tylerkolden/desktop-companion-robot/docs/PLAN.md

# Development plan

## Current teaching architecture

Seven separate lesson pages and sketches replace the stacked Companion lesson flow. Test acceleration, rotation rate, die temperature, OLED and servo control independently, then integrate. Shared command handling keeps the interface consistent. The owner reports all seven current lessons completed successfully, including satisfactory larger servo movement. This is user-reported bench evidence, not a measured mechanical-range or four-leg validation. See the test log.

## Current build checkpoint

[Checkpoint 4: screw-retained servo mount](BUILD-CHECKPOINT-04.md) is current. Preserve the owner-approved 23 x 12.9mm opening. V4 replaces snap tabs with two M2 x 10mm machine screws, nuts and flat washers; cable entry moves to the long side. Print and check one before designing the chassis. M2 passage through the actual ear holes, cable insertion, washer seating and retention remain unverified. The sensor/personality app is paused at the owner's request. No assembled leg should use the bare-servo sweep without checking its mechanical limits.

## Milestone 0: documented starting point

- [x] Add repository-local pinned tool bootstrap and a documented Windows terminal workflow.
- [x] Add standalone Hello, Scanner, Face, and Motion teaching sketches with staged lessons.
- [x] Document beginner setup, command meanings, troubleshooting, experiment records, and contribution workflow.
- [ ] Have a new learner follow the guide and record confusing steps.

- [x] Study upstream code and missing model situation.
- [x] Record owned hardware and Amazon-only selections.
- [x] Choose solder-free assembly, corded V1 and cordless V2.
- [x] Draft wiring, measurement, build and validation instructions.
- [x] Owner confirmed all additional V1 parts are in hand.
- [ ] Complete receipt checks and physical validation.

## Milestone 1: bench diagnostics

- [x] Implement serial commands, scanning, display, IMU polling and one-channel calibration in `firmware/Companion/` (physical validation pending).
- [x] Add I2C scanner and serial diagnostics; compile for XIAO ESP32C3.
- [x] Pin exact board/library versions and document a repeatable build.
- [ ] Validate OLED and IMU separately.
- [x] Implement PCA9685 one-servo calibration with outputs disabled at initialization; hardware behavior still requires validation.
- [ ] Measure supply behavior and calibrate four unloaded servos.

Exit: repeatable upload, detected modules, stable power, recorded calibration.

## Milestone 2: editable mechanical design

- [x] Create and mesh-check original servo/OLED outline fit gauges with editable OpenSCAD source.
- [ ] Measure actual boards, servo horns and connector envelopes.
- [ ] Model servo cradle and display mount fit coupons.
- [ ] Print, measure and revise coupons.
- [ ] Design lightweight chassis, removable shell, four legs and cord strain relief.
- [ ] Use captive nuts or accessible screws; avoid heat-set inserts and permanent glue for service parts.
- [ ] Specify final Amazon fasteners and count; retain original servo horn screws.
- [ ] Export versioned CAD, STL and printer settings; verify meshes and physical fit.

Exit: assembled shell with accessible plugs, no binding, and documented fasteners.

## Milestone 3: V1 behavior

- [x] Implement initial animated face, idle timer, double-tap detector and a manually armed 10-second limited gesture (hardware tuning pending).
- [ ] Separate display, sensing, motion, behavior and configuration modules.
- [ ] Use a non-blocking scheduler; continue sensing during animations.
- [ ] Implement real double-tap timing/debounce, orientation hysteresis and recovery.
- [ ] Separate last-user-interaction time from animation time so idle sleep works.
- [ ] Clamp motion to per-servo limits; handle missing sensors conservatively.
- [ ] Add stand/sit, blink/sleep, small gestures and predictable startup.
- [ ] Optional after baseline: local Wi-Fi controls with motion stop and credentials outside git.

## V1 release acceptance

- [ ] Reproduce firmware build from a clean checkout.
- [ ] Verify startup with servo supply disconnected until controller initialization succeeds; software cannot guarantee pulse shutdown through an MCU-only reset.
- [ ] Demonstrate display, motion sensing and four calibrated legs.
- [ ] Demonstrate tap timeout, orientation response and idle sleep.
- [ ] Run a 30-minute supervised gesture/idle cycle without observed resets, binding or loose wires.
- [ ] Check power during startup and simultaneous motion; document measurement limitations.
- [ ] Confirm cable strain relief, component retention and access to unplug power.
- [ ] Build without soldering or undocumented modifications.
- [ ] Record tested hardware revisions, CAD revision, settings, fasteners and limitations.

Walking and desk-edge avoidance are not release promises. No unattended movement near an edge.

## V2: cordless

Begin only after V1 current, mass and motion requirements are measured. The existing JLJLUP pack is 3000mAh, 65 x 36 x 10mm and 49g. Its listing says both 1C (implying 3A) and an explicit maximum of about 1.5A. Use the more restrictive limit; the pack is not selected for four-servo power. At nominal voltage, 1.5A gives 5.55W input, or roughly 0.94-1.0A at 5V for 85-90% conversion efficiency, before controller consumption.

- [ ] Capture typical and peak current with suitable measurement equipment.
- [ ] Set runtime, mass, regulator and connector requirements from measurements.
- [ ] Select a compatible preassembled battery, charging and regulation solution on Amazon.
- [ ] Verify connector family and polarity; a generic JST1.25 description is insufficient.
- [ ] Define power switching, low-voltage cutoff and charge/use behavior.
- [ ] Revise removable power compartment and center of mass.
- [ ] Test runtime, temperature, peak-load stability and charging independently.

Do not improvise series/parallel combinations of the two existing batteries. No V2 battery or charger is approved in this plan yet.
