tylerkolden/desktop-companion-robot/cad/oled-fit-preview.png

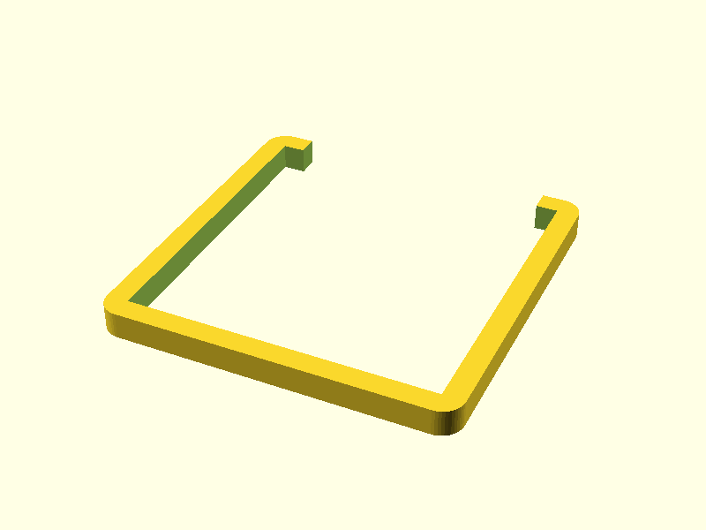
cad/oled-fit-preview.png
