tylerkolden/desktop-companion-robot/cad/servo-cradle-v2-preview.png

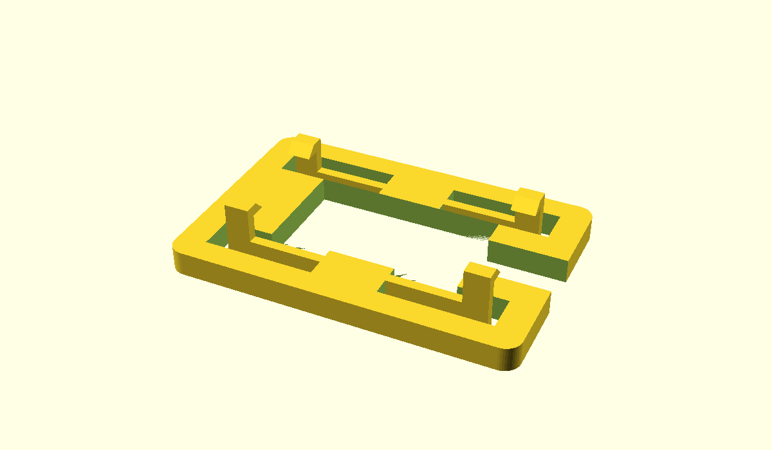
cad/servo-cradle-v2-preview.png
