tylerkolden/desktop-companion-robot/docs/book/images/cover.jpg

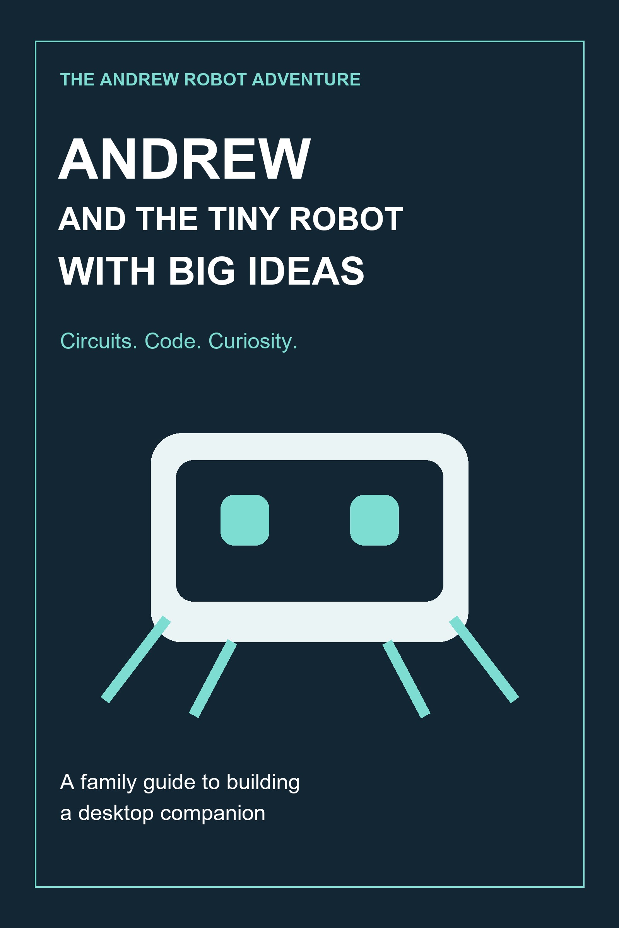
docs/book/images/cover.jpg
