tylerkolden/desktop-companion-robot/docs/faces/face-gallery.png

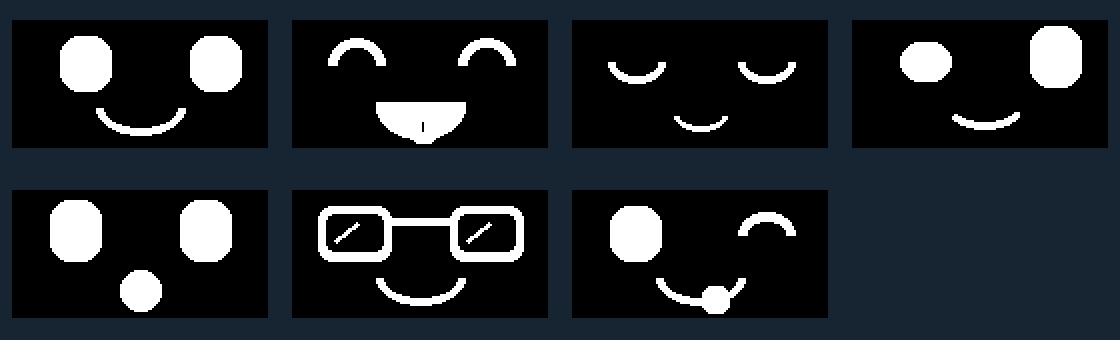
docs/faces/face-gallery.png
