tylerkolden/desktop-companion-robot/docs/SHOPPING-LIST.md

# Amazon-only shopping list

Wiring reference: [full pinout atlas and verification limits](wiring/README.md). Use the stage matching your lesson; do not connect every pictured module at once.
<!-- wiring:start -->
**Parts for this power checkpoint:** a regulated 5V wall supply, its low-voltage connector and prepared wires, and a multimeter. For the motor connection, also identify the SG90 servo and PCA9685 driver. The supply powers the motor through the driver; the meter checks its output before connection. Identify these parts before following the diagram.

### Wiring visuals and pinouts

**Before assembling these connections: close the monitor and unplug the XIAO USB cable. Keep the newly introduced 5V supply unplugged from the wall until the voltage-check step. On a repeat session, unplug it before changing wires.** These are functional illustrations: locate terminals by their printed labels. Board shapes do not establish physical pin positions.

SERVO wiring: labelled endpoints and separate power paths

**Identify the green two-screw block on the PCA9685:** its + / V+ terminal accepts the regulated 5V supply positive wire; its - / GND terminal accepts the negative wire. They are not both V+. This block is not VCC, and it is different from the separate barrel-to-terminal connector on the supply cable. Confirm the actual board markings with power unplugged; the illustration does not establish left/right orientation. Functional servo pinout: ground, power, signal. Read the driver row labels before inserting the plug. **Keep all four XIAO logic wires connected**, as shown in this complete diagram: 3V3/VCC, GND/GND, D4/SDA and D5/SCL. The shared-ground wire is one of these four wires, not an extra fifth wire. Channel 0 is the three-pin output group beside the printed 0 among groups 0 through 15. One plug spans GND, V+ and signal within that group, not three neighboring channel numbers. The green block is not channel 0. Verify actual markings; left/right orientation is not established by this diagram. Use only channel 0 for this experiment. USB and adapter grounds meet at PCA GND; adapter positive never meets XIAO 5V or 3V3. Grounded OE is not a reset interlock: unplug servo power for uploads, resets and horn fitting.

| From / pin | To / pin | Meaning |
|---|---|---|
| Adapter positive | PCA green block: + / V+ | Regulated 5V; direct power wire |
| Adapter negative | PCA green block: - / GND | Direct power wire |
| XIAO 3V3 | PCA VCC | Logic power, separate from V+ |
| XIAO GND | PCA GND | Common reference |
| XIAO D4 / GPIO6 | PCA SDA | I2C data |
| XIAO D5 / GPIO7 | PCA SCL | I2C clock |
| PCA channel 0 GND | SG90 ground | Usually brown/black; verify |
| PCA channel 0 V+ | SG90 power | Usually red; verify |
| PCA channel 0 PWM | SG90 signal | Usually orange/yellow; verify |

PCA wiring: labelled endpoints and separate power paths

The green two-screw block is a separate power input: one terminal is + / V+, the other is - / GND. It stays empty during this communication-only test; the driver electronics receive power through VCC. Follow the board markings, not a guessed left/right position. Functional pinout: VCC = logic 3.3V; V+ = separate output-power input; GND = common ground; SDA/SCL = I2C; OE = active-low output enable. Exact clone header order is unconfirmed. Verify OE pull-down; ground OE only if floating. Use only VCC, GND, SDA and SCL for this communication test. Leave V+ and the numbered output connectors empty.

| From / pin | To / pin | Meaning |
|---|---|---|
| XIAO 3V3 | Teyleten PCA9685 VCC | 3.3V logic |
| XIAO GND | Teyleten PCA9685 GND | Shared ground |
| XIAO D4 / GPIO6 | Teyleten PCA9685 SDA | I2C data |
| XIAO D5 / GPIO7 | Teyleten PCA9685 SCL | I2C clock |

METER wiring: labelled endpoints and separate power paths

Probe-jack pinout is functional, not the physical socket position of every meter variant. Select DC voltage before probing. Verify barrel size and polarity against the actual adapter; do not assume center-positive from a generic picture.

| From / pin | To / pin | Meaning |
|---|---|---|
| Black probe / COM jack | Adapter negative output | Voltage check only |
| Red probe / V-ohm jack | Adapter positive output | DC volts; never current mode |

<!-- wiring:end -->

Reviewed September 13, 2026. Links identify the researched ASIN, not a guarantee of seller, price, inventory, accessory inclusion, or unchanged variants. Quantities below distinguish pieces used from packs purchased. Selected does not mean ordered or physically tested.

**Owner update: all additional V1 parts are now in hand.** Do not reorder this list. Voltage/polarity, accessory inclusion, installed headers and physical fit still need the receipt/bench checks below. Filament and CAD-dependent fasteners remain unconfirmed.

## Already reported owned

| Component | Used in V1 | Amazon listing | Receipt check |
|---|---:|---|---|
| XIAO ESP32C3, pre-soldered | 1 | [B0DRNSV5CS](https://www.amazon.com/dp/B0DRNSV5CS) | C3 model, installed headers, included antenna |
| SG90 positional servo | 4 | [B0C7KPXPQV](https://www.amazon.com/dp/B0C7KPXPQV) | At least four; horns and horn screws; not continuous-rotation units |
| SSD1306 I2C OLED, 128 x 64 | 1 | [B0F5WPZJ92](https://www.amazon.com/dp/B0F5WPZJ92) | Photos show installed four-pin header; confirm actual delivery |
| Pre-soldered GY-521 MPU6050 | 1 | [B0D2TJVMNY](https://www.amazon.com/dp/B0D2TJVMNY) | Installed header and labeled pin order |
| Mini breadboards | As needed, start with 2 | [B0146MGBWI](https://www.amazon.com/dp/B0146MGBWI) | Check contact layout; used only for logic/sensor distribution |
| Assorted Dupont jumpers | About 16-20, depending on layout | [B01EV70C78](https://www.amazon.com/dp/B01EV70C78) | Male/female types for installed headers and breadboards |
| Bambu Lab A1 | 1 | [B0D17TMWFB](https://www.amazon.com/dp/B0D17TMWFB) | Actual nozzle and available filament still to confirm |
| JLJLUP LiPo batteries | **0** | [B0FH9BLZWB](https://www.amazon.com/dp/B0FH9BLZWB) | Keep out of V1; unsuitable as the planned four-servo supply |

## Additional electronics and tools selected

| Item | Buy | Amazon link | Why / qualification |
|---|---:|---|---|
| Teyleten PCA9685 driver | 1 two-pack; use 1 board | [B0CNVBWX2M](https://www.amazon.com/dp/B0CNVBWX2M) | Product photo shows installed servo pins, one installed control header, capacitor and screw terminal. Other side's empty header holes need not be populated. |
| Fixed 5V/4A wall supply | 1 | [B0D65GK31F](https://www.amazon.com/dp/B0D65GK31F) | Correct advertised rating. Photo shows female barrel-to-terminal accessory; written package description is less explicit. Verify output label, polarity, accessory inclusion and load performance. Certification not independently verified. |
| Haerkn 20-AWG red/black copper wire | 1 pack | [B08F79YG8Q](https://www.amazon.com/dp/B08F79YG8Q) | Short adapter-to-driver power runs. Comes on spools; cut and strip. Tinned copper strands do not require user soldering. |
| WGGE WG-015 stripper/cutter | 1 | [B073YG65N2](https://www.amazon.com/dp/B073YG65N2) | Photo has 20-AWG setting on STRD side. Test on scrap and avoid severing strands. |
| AstroAI digital multimeter | 1 | [B01ISAMUA6](https://www.amazon.com/dp/B01ISAMUA6) | DC voltage, continuity and polarity checks; listed with leads and batteries. |
| Amazon Basics USB-A to USB-C data cable | 1 if needed | [B01GGKYKQM](https://www.amazon.com/dp/B01GGKYKQM) | Supports programming. Requires a USB-A host port. If computer only has USB-C, select a data-capable C-to-C cable instead. |
| Precision screwdriver set | 1 | [B07PV5D3VV](https://www.amazon.com/dp/B07PV5D3VV) | Includes 2.4/3.0mm flatheads and Phillips #00/#0/#1. Choose snug fit. |

## Conditional substitute, not an extra mandatory purchase

If the supply does not include its pictured terminal adapter, [CENTROPOWER B07C7VSRBG](https://www.amazon.com/dp/B07C7VSRBG) provides male/female 5.5 x 2.1mm pigtails with 18-AWG conductors. Use one **female** cable, after confirming the supply plug size and polarity. This can replace both the adapter and the short loose-wire connection. The listing's 12V label does not mean the passive cable creates 12V. Do not buy this pack unless needed; it contains many spares. Check terminal suitability for the prepared wire ends and perform a gentle pull test.

## Still required for the complete physical robot

- [ ] **Filament:** check what is already owned. Plan 1.75mm PLA for initial fit tests; final material/profile follows mechanical testing. No specific Amazon ASIN selected yet.
- [ ] **Fasteners:** servo horns/screws should come with the servos. Body screws, captive nuts, spacers and cable retention await CAD. Avoid buying arbitrary lengths now; no heat-set inserts required in the planned solder-free assembly.
- [ ] **USB power away from a computer:** existing USB supply may suffice for controller only; otherwise select an Amazon USB supply. Current bench plan assumes the computer powers the XIAO.
- [ ] **Measurement tool:** a millimeter ruler can start the measurement sheet; calipers are useful for mounting holes and fit dimensions if available.
- [ ] Verify the terminal adapter is included, control headers are installed, and computer cable matches the host.

**Conclusion:** the selected items support bench bring-up once delivered and checked. A complete enclosure shopping list cannot be frozen until the CAD and physical dimensions are verified.

## Not needed for V1

Soldering iron, solder, battery charger, boost converter, replacement controller, replacement display, camera, Raspberry Pi, or a separate servo tester. Firmware will provide controlled servo calibration. V2 purchases are deferred until measured power requirements are known.

## V4 servo-mount fasteners (2026-10-25)

For one mount: **2 M2 x 10mm socket-head machine screws, 2 M2 hex nuts, 4 M2 flat washers**. For four: 8 screws, 8 nuts, 16 washers. Keep spares. Standard thread is M2 x 0.4. Use a 1.5mm hex key and small pliers; verify tools fit.

Amazon: [VGBUY 840-piece M2 assortment](https://www.amazon.com/dp/B0FJ1XLMJT). Reviewed Amazon contents list 10mm screws, matching nuts and flat washers among other sizes. Select M2, not M2.5 or M3. Tool inclusion and current delivery are unconfirmed. [Full purchase and assembly instructions](BUILD-CHECKPOINT-04.md) include Amazon tool searches and the unpowered screw-passage check. The seller servo drawing does not dimension the mounting holes, so physical M2 compatibility is still a checkpoint, not a verified promise.

This specifies case-mount fasteners only. Chassis and horn fasteners remain separate.
