tylerkolden/desktop-companion-robot/cad/stl/servo-cradle-v4.stl

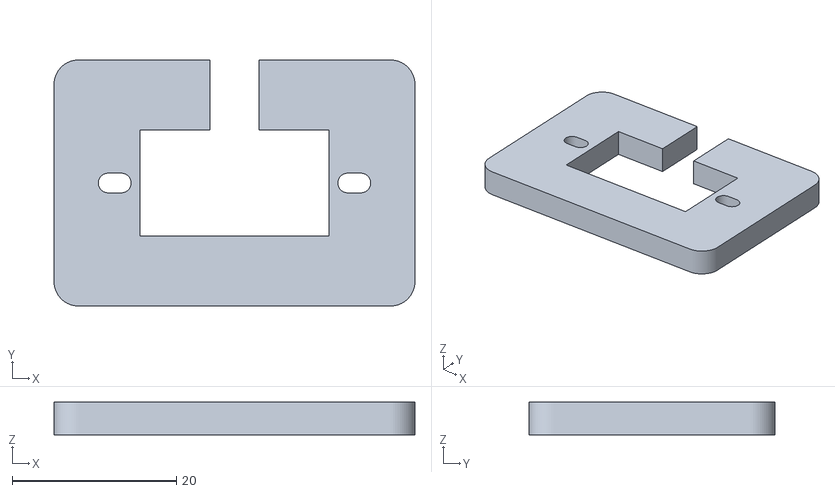
[picture p20: CAD file, 2026-10-26]
cad/stl/servo-cradle-v4.stl
44.0 x 30.0 x 4.00
