tylerkolden/desktop-companion-robot/cad/stl/servo-fit-gauge.stl

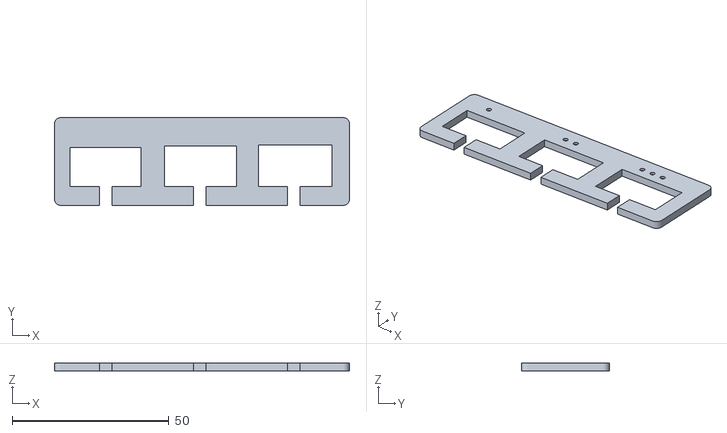
[picture p21: CAD file, 2026-09-29]
cad/stl/servo-fit-gauge.stl
94.0 x 28.0 x 2.40
