tylerkolden/desktop-companion-robot/cad/stl/oled-fit-gauge.stl

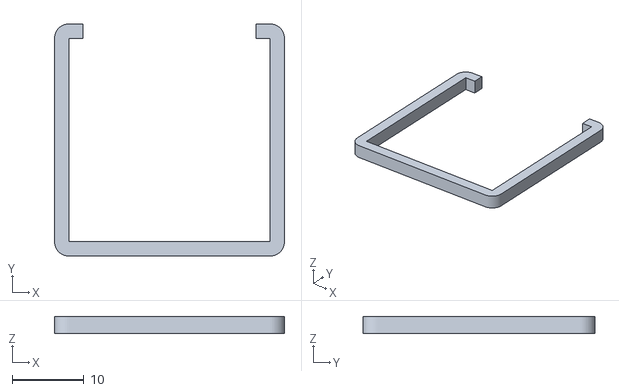
[picture p22: CAD file, 2026-09-14]
cad/stl/oled-fit-gauge.stl
32.0 x 32.3 x 2.40
