tylerkolden/desktop-companion-robot/cad/stl/servo-cradle-v3.stl

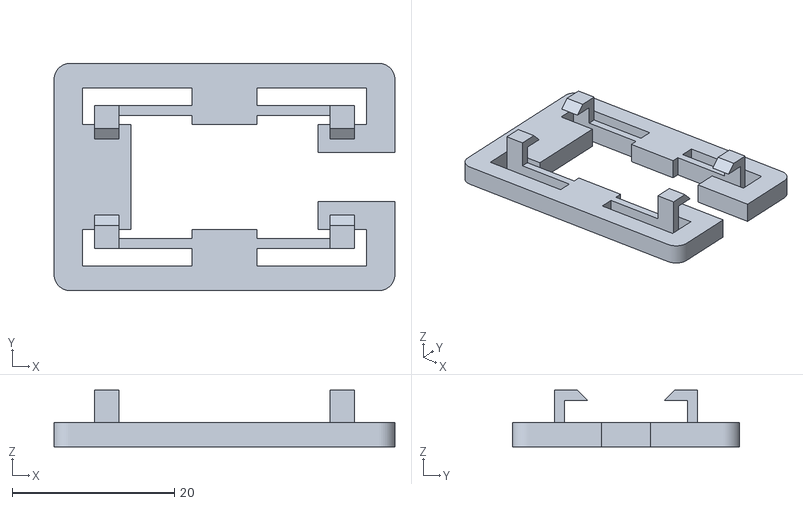
[picture p23: CAD file, 2026-10-26, an earlier design]
cad/stl/servo-cradle-v3.stl
42.0 x 28.0 x 7.00
