tylerkolden/desktop-companion-robot/cad/stl/servo-cradle-v2.stl

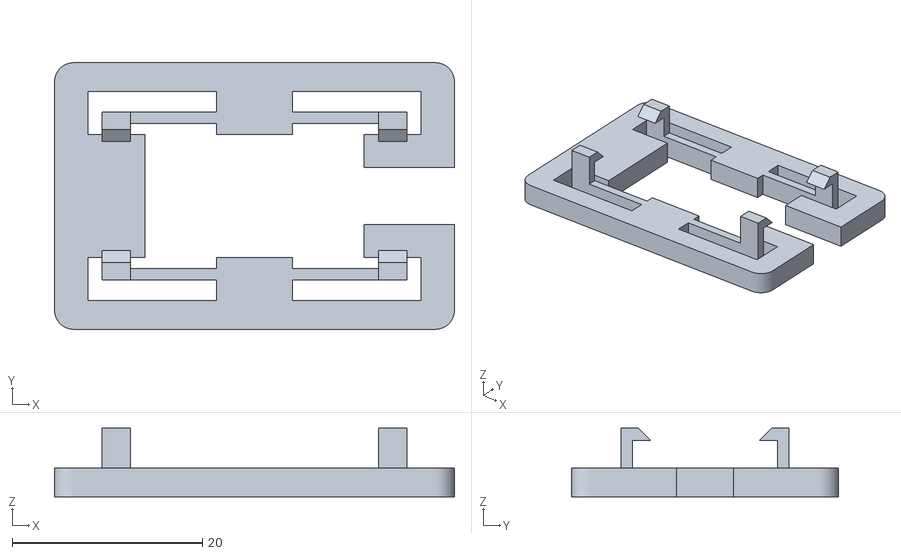
[picture p24: CAD file, 2026-10-18, an earlier design]
cad/stl/servo-cradle-v2.stl
42.0 x 28.0 x 7.20
