tylerkolden/desktop-companion-robot/cad/stl/servo-cradle-v1.stl

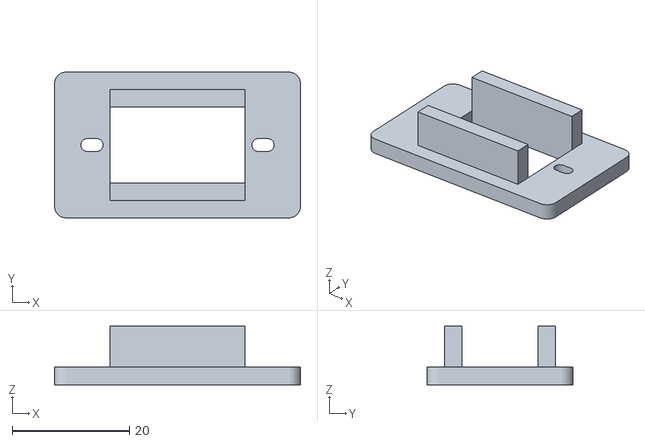
[picture p25: CAD file, 2026-10-14, an earlier design]
cad/stl/servo-cradle-v1.stl
42.0 x 24.9 x 10.0
