tylerkolden/desktop-companion-robot/(list of files, cad)

Other CAD files:
cad/servo-cradle-v1.scad
cad/servo-cradle-v2.scad
cad/servo-cradle-v3.scad
