tylerkolden/desktop-companion-robot/docs/MEASUREMENTS.md

# Physical measurement sheet

Record millimeters. Listing dimensions are provisional until checked against actual parts. Allow cable bend radius and finger/tool access; board outlines alone are insufficient.

| Item | Known | Measure before CAD freeze |
|---|---|---|
| XIAO C3 | Nominal board 21 x 17.8mm | Height with headers, USB plug length, antenna clearance |
| OLED | 0.96-inch active diagonal, not board size | PCB width/height/thickness, hole spacing/diameter, visible opening, rear pin height |
| GY-521 | MPU6050 module | PCB dimensions, holes, tallest parts, header envelope |
| PCA9685 | Seller says 60 x 25mm | Actual outline, holes, capacitor height, side header and terminal access |
| SG90 x4 | WWZMDiB B0C7KPXPQV: listing-derived 22.6 x 12.5mm body footprint; [source and discrepancy](../cad/SERVO-DIMENSIONS.md) | Body, mounting ears/holes, shaft position, horn dimensions, cable exit; clones vary |
| Mini breadboards | Owned pack | Actual placement footprint and contact grouping |
| LiPo, not used V1 | 65 x 36 x 10mm, 49g each, ~70mm leads | Not a V2 compartment constraint until a battery is selected |
| A1 | Nominal 256mm cubic build volume | Installed nozzle, filament type and printer profile |

Attach labeled photos beside a ruler when dimensions are hard to describe. Photograph servo horns on both sides and each PCB's connector labels. Do not estimate hole positions from perspective product photos.
