tylerkolden/desktop-companion-robot/templates/EXPERIMENT.md

# Experiment record

- Date / learners:
- Question:
- Prediction and reason:
- Firmware commit / sketch:
- Toolchain versions:
- Connected modules and wiring:
- Adult power/motion checks:
- One change:
- Commands / measured values with units:
- Expected result:
- Observed result:
- Pass / fail / inconclusive and why:
- What this does NOT prove:
- Next smallest test:

Do not add passwords, account details, or identifying photos without review.
## Wiring evidence

- Stage-specific diagram and pinout from the [atlas](../docs/wiring/README.md):
- Actual module model / orientation / matching printed labels:
- Adult checked every connection against the table with power unplugged:
- Any difference from the proposed diagram (stop and resolve before power):
