tylerkolden/desktop-companion-robot/templates/LESSON-RESULT.md

# Lesson observation

- Date, learner and observer:
- Lesson page / sketch / Git revision:
- Hardware actually connected:
- Prediction (before the test):
- Exact commands sent:
- Actual observation, values and units:
- Repeat observation:
- Result: observed / not observed / not sure
- What this proves:
- What this does NOT prove:
- Teammate's explanation in their own words:
- One next question or change:
- End state (power and connected hardware):

Use the lesson's exit criteria. Do not mark a physical pass based only on compilation, an address reply or a program's DONE message.
