tylerkolden/desktop-companion-robot/(commit log)

2026-09-14 Document solder-free robot build, Amazon BOM, and V1/V2 roadmap
2026-09-14 Add compiled bench firmware, printable fit gauges and power-on guide
    [fit-tests.scad, oled-fit-gauge.stl, servo-fit-gauge.stl]
2026-09-15 Fix local Arduino CLI discovery and Windows build paths
2026-09-21 Add configurable upload baud and document ESP32 transfer recovery
2026-09-21 Add wiring visuals and pinout tables throughout beginner guides and book
2026-09-21 Clarify lesson hardware transitions and defer first servo to integration
2026-09-21 Make generated wiring preparation match each lesson's hardware
2026-09-21 Verify driver independently before combining tested modules
2026-09-21 Add timed unloaded servo test and evidence-based device lessons
2026-09-21 Add beginner-friendly named device reports and technical details command
2026-09-21 Identify green PCA9685 power terminal block in wiring guides and diagrams
2026-09-21 Show all four XIAO logic wires in complete servo circuit diagram
2026-09-21 Add guided motor monitor experience and channel zero identification
2026-09-21 Add sequential 16-channel finder for one unloaded servo
2026-09-21 Make lesson 5C a staged kid-friendly wiring walkthrough
2026-09-21 Add bounded one-servo personality show and lesson 5D
2026-09-21 Clarify PowerShell versus monitor input and lesson command checkpoints
2026-09-26 Add servo-only Big Wiggle lesson with bounded repeated motion
2026-09-29 Animate robot dog expressions and replace heart eyes with sunglasses
    [build_faces.py, build_lessons.py, check_faces.py]
2026-09-29 Add guided servo endpoints and full checked-range sweep
2026-09-29 Guide servo calibration with simple more back keep prompts
2026-09-29 Replace calibration workflow with a simple preset motor lesson
    [build_lessons.py]
2026-09-29 Increase practice servo excursion by 2.5x
2026-09-29 Double practice servo pulse excursion
2026-09-29 Record lesson completion and add first servo fit checkpoint
2026-09-29 Size servo gauge from exact Amazon listing dimensions
    [fit-tests.scad, servo-fit-gauge.stl]
2026-10-01 Record successful two-dot servo gauge fit
2026-10-14 Add printable servo cradle and guided fit checkpoint
    [servo-cradle-v1.scad, servo-cradle-v1.stl]
2026-10-18 Add screw-free cradle with cable entry slot and snap tabs
    [servo-cradle-v2.scad, servo-cradle-v2.stl]
2026-10-26 Extend and lower servo snap hooks after loose V2 fit
    [servo-cradle-v3.scad, servo-cradle-v3.stl]
2026-10-26 Add TypeScript RoboDog practice lab with three-axis sensor reactions
2026-10-26 Replace snap cradle with screw-retained V4 and beginner assembly guide
    [servo-cradle-v4.scad, servo-cradle-v4.stl]
